bblacey/MySensorIRBlaster/Schematic.pdf

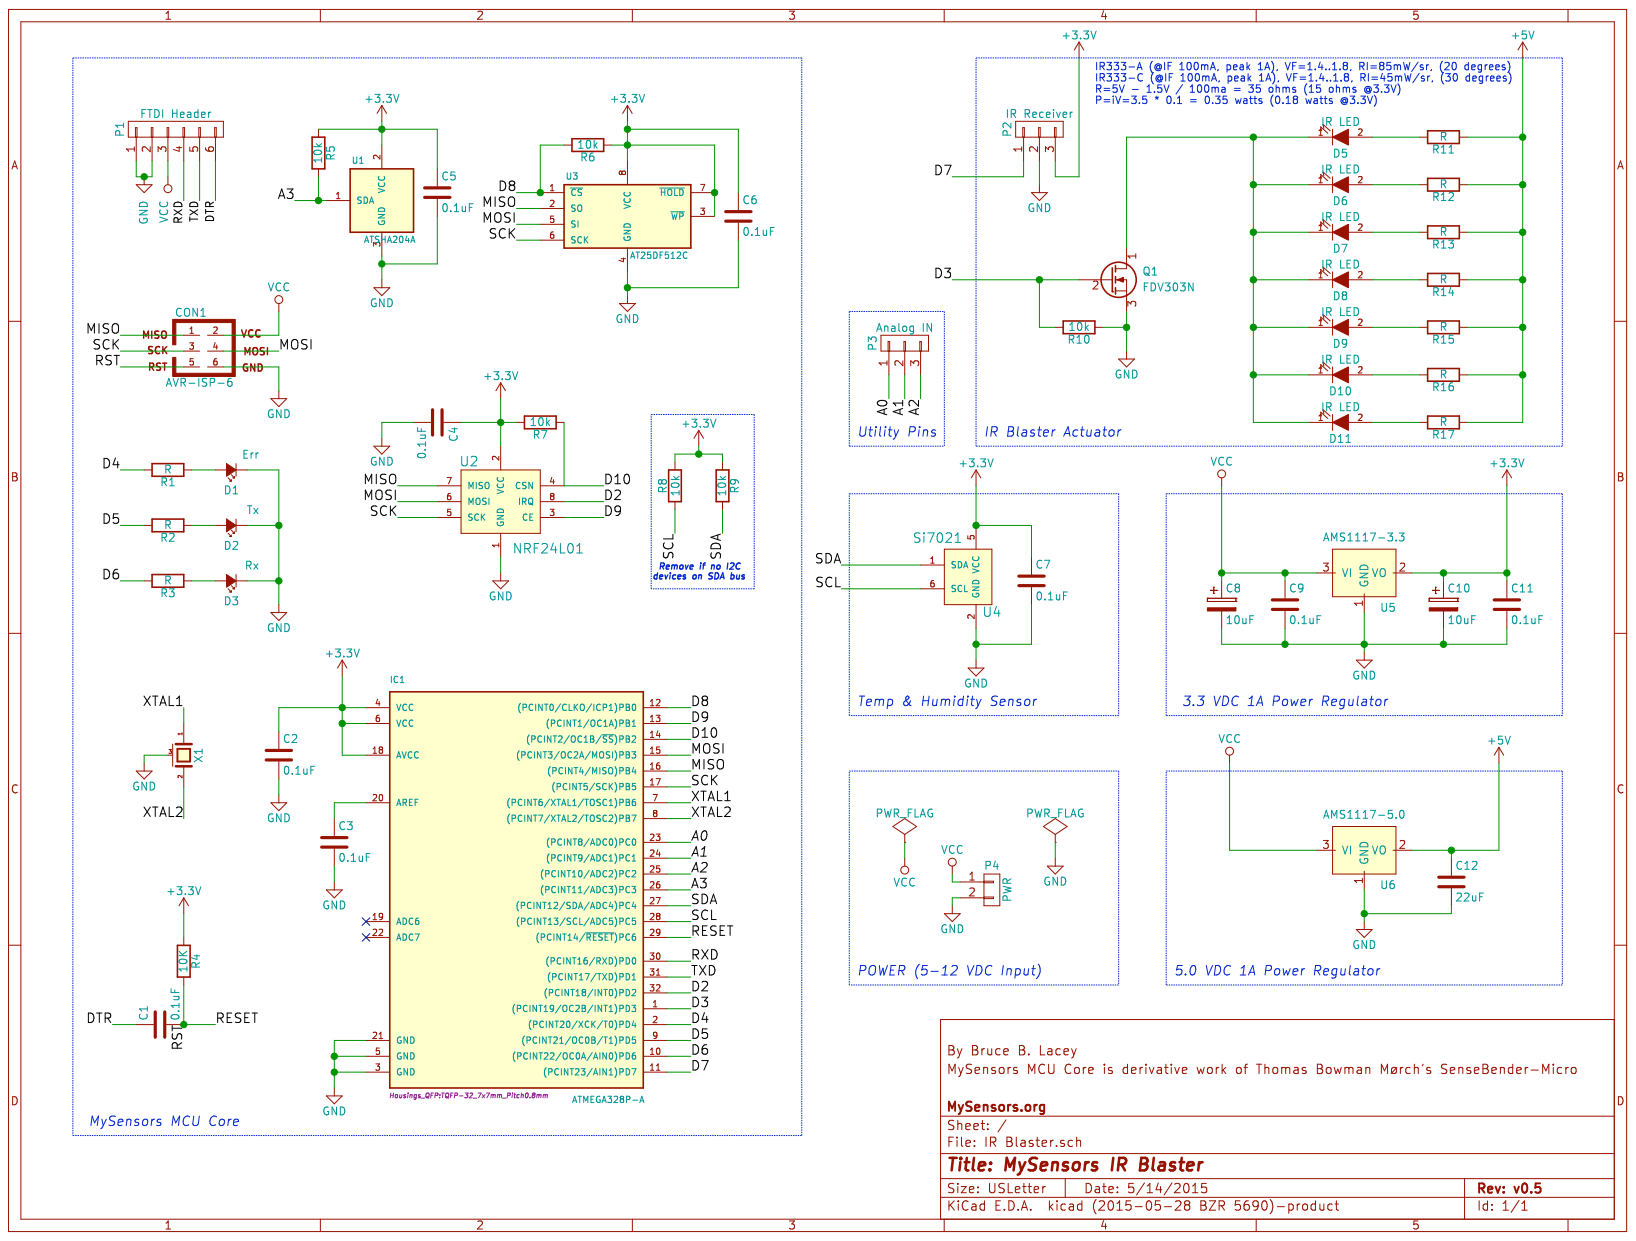
[picture p1: page 1]
