bblacey/MySensorIRBlaster/IR Blaster.kicad_pcb

## KiCad design IR Blaster.kicad_pcb (2015-06-25)

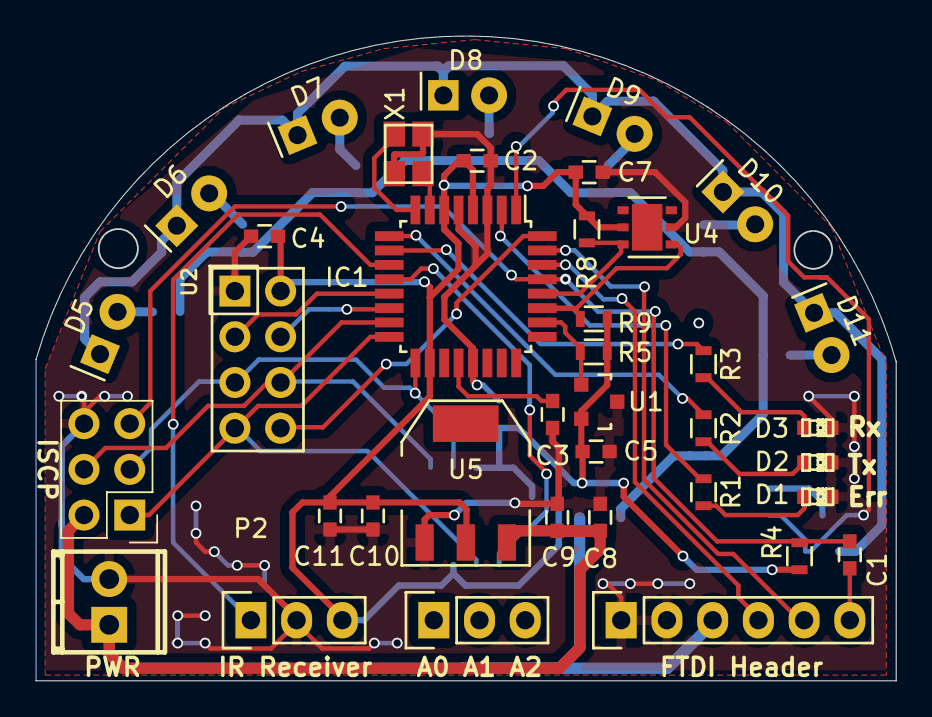
[picture p2: board IR Blaster.kicad_pcb from above]

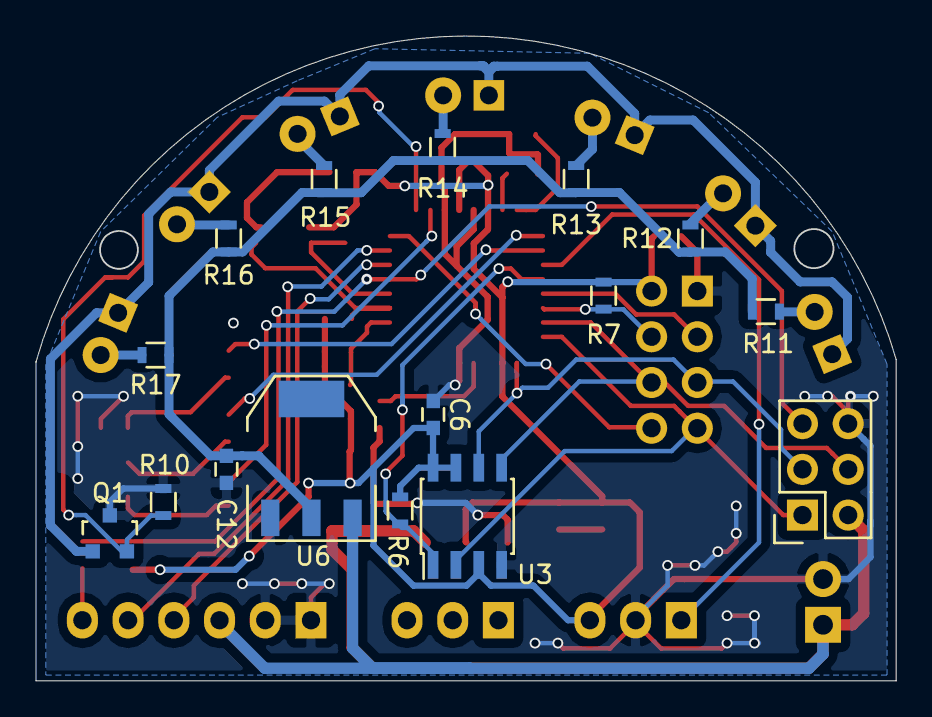
[picture p3: board IR Blaster.kicad_pcb from below]

Board: 2 copper layers, 47.8 x 35.8 mm, 53 parts (16 on the bottom side), 40 nets.

Parts:
C1, C2, C3, C4, C5, C6, C7, C9, C11: 0.1uF; C_0603
C8, C10: 10uF; C_0603
C12: 22uF; C_0603
CON1: AVR-ISP-6; Socket_Strip_Straight_2x03
D1: Err; LED-0603
D2: Tx; LED-0603
D3: Rx; LED-0603
D5, D6, D7, D8, D9, D10, D11: IR LED; LED-5MM-Horizontal
IC1: ATMEGA328P-A; TQFP-32_7x7mm_Pitch0.8mm
P1: FTDI Header; Pin_Header_Straight_1x06
P2: IR Receiver; Socket_Strip_Straight_1x03
P3: Analog IN; Pin_Header_Straight_1x03
P4: PWR; TerminalBlock2.54mmx2-kcswalter
Q1: FDV303N; SOT-23
R1, R2, R3, R11, R12, R13, R14, R15, R16, R17: R; R_0603
R4: 10K; R_0603
R5, R6, R7, R8, R9, R10: 10k; R_0603
U1: ATSHA204A; SOT-23
U2: NRF24L01
U3: AT25DF512C; SOIC-8_3.9x4.9mm_Pitch1.27mm
U4: Si7021; DFN-6-1EP_3x3mm_Pitch0.95mm
U5: AMS1117-3.3; SOT-223
U6: AMS1117-5.0; SOT-223
X1: CRYSTAL; crystal_FA238-TSX3225

Connections:
+3V3: C2.1, C4.1, C5.1, C6.1, C7.1, C10.1, C11.1, IC1.4, IC1.6, IC1.18, P2.3, R4.1, R5.1, R6.1, R7.2, R8.2, R9.1, U1.2, U2.2, U3.3, U3.7, U3.8, U4.5, U5.2
+5V: C12.1, R11.1, R12.1, R13.1, R14.1, R15.1, R16.1, R17.1, U6.2
/A0: IC1.23, P3.1
/A1: IC1.24, P3.2
/A2: IC1.25, P3.3
/A3: IC1.26, R5.2, U1.1
/D2: IC1.32, U2.8
/D3: IC1.1, Q1.2, R10.2
/D4: IC1.2, R1.2
/D5: IC1.9, R2.2
/D6: IC1.10, R3.2
/D7: IC1.11, P2.1
/D8: IC1.12, R6.2, U3.1
/D9: IC1.13, U2.3
/D10: IC1.14, R7.1, U2.4
/DTR: C1.1, P1.6
/MISO: CON1.1, IC1.16, U2.7, U3.2
/MOSI: CON1.4, IC1.15, U2.6, U3.5
/RESET: C1.2, CON1.5, IC1.29, R4.2
/RXD: IC1.30, P1.4
/SCK: CON1.3, IC1.17, U2.5, U3.6
/SCL: IC1.28, R8.1, U4.6
/SDA: IC1.27, R9.2, U4.1
/TXD: IC1.31, P1.5
/XTAL1: IC1.7, X1.1
/XTAL2: IC1.8, X1.2
GND: C2.2, C3.2, C4.2, C5.2, C6.2, C7.2, C8.2, C9.2, C10.2, C11.2, C12.2, CON1.6, D1.1, D2.1, D3.1, IC1.3, IC1.5, IC1.21, P1.1, P1.2, P2.2, P4.2, Q1.3, R10.1, U1.3, U2.1, U3.4, U4.2, U5.1, U6.1, X1.3
unnamed: C3.1, IC1.20
unnamed: D1.2, R1.1
unnamed: D2.2, R2.1
unnamed: D3.2, R3.1
unnamed: D5.2, R11.2
unnamed: D6.2, R12.2
unnamed: D7.2, R13.2
unnamed: D8.2, R14.2
unnamed: D9.2, R15.2
unnamed: D5.1, D6.1, D7.1, D8.1, D9.1, D10.1, D11.1, Q1.1
unnamed: D10.2, R16.2
unnamed: D11.2, R17.2
VCC: C8.1, C9.1, CON1.2, P1.3, P4.1, U5.3, U6.3
