bblacey/MySensorIRBlaster/(threads)

Thread 1 (2015-07-04):

Change MOSFET footprint to GSD and re-route

bblacey, 2015-07-04:
The current MOSFET DGS footprint is less common for enhanced MOSFETs eliminating a large number of good candidates.  Need to rev the PCB to use a GSD footprint

Thread 3 (2015-07-04):

Learn mode activation

bblacey, 2015-07-04:
Currently there is not a convenient way to place the IR Blaster into learn mode.  One option is to detect the presence of an IR Receiver in the socket during firmware boot, another would be to send a message from the HA Controller or a third is to consider adding a small physical button to the PCB (cost?).

Thread 4 (2015-07-04):

Re-route MOSFET gate trace around hold-down screw to reduce probability of fastener damage

bblacey, 2015-07-04:
Currently the MOSFET gate line is routed around the outside of the LED array and past the interior side of the hold-down screw hole.  It is close enough that if users tighten the hold-drown screw, it could damage the trace.

Thread 5 (2015-07-04):

Increase clearance between D5 trace and AMS1117 LDO regulator on bottom-side

bblacey, 2015-07-04:
While it is within the design specs, the trace appears to be physically closer to the AMS1117 large pin than desired.

Thread 6 (2015-07-07):

Finalize 3.3v MCU power regulator coupling capacitors

bblacey, 2015-07-07:
Ensure 3.3v coupling capacitor capacity is sufficient to handle MCU, flash, ASTHA crypto chip and radio power surge demands.

bblacey, 2015-07-09:
LDO will oscillate and won't settle unless capacitors are of sufficient capacitance.  Ceramic and Tantalum capacitance differ in an important manner for the input side (RMS or EMF which is a secondary value but also important).  Arduino tends to use 47uf on the input side.

Thread 7 (2015-07-07):

Correct crystal footprint for 8-12MHz SMD crystals

bblacey, 2015-07-07:
The current footprint accommodates a 32MHz crystal but needs to accommodate an 8-12MHz SMD crystal @3.3VDC.  The common footprint size seems to be 5mm x 3.2mm dual pad.  Representative crystals can be found here http://www.mouser.com/Passive-Components/Frequency-Control-Timing-Devices/Crystals/_/N-6zu9f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

bblacey, 2015-07-12:
Crystals - http://www.tme.eu/en/pages/New_Product:smd-quartz-crystals-from-yic.html

Thread 8 (2015-07-07):

Formally include BOM parts in KiCad

bblacey, 2015-07-07:
1.  Define BOM parts in schematic symbol labels
2.  Create BOM extraction using Python scripts that Patrick provided

Thread 9 (2015-07-07):

5VDC vs. 3.3VDC for IR LED circuit

bblacey, 2015-07-07:
The v0.5 version of the IR LED circuit was 5V requiring 35 ohm 0.35watt current limiting resistors and was laid out using 0603 resistor footprints.  During part selection, I found that it was nearly impossible to find a resistor that could meet the power requirements so for the dev board, I reverted to driving the IR LEDs with 3.3v allowing the use of a 15 ohm 0.18 watt resistor in the 0603 package.

The open issue is which voltage should be used for the final board.  If 5VDC, then at a minimum, we need to change the resistor footprint to 0805.

tbowmo, 2015-07-08:
If you could put in an extra led,  so you have 8 in total,  then put  2 in series with a resistor,  multiply with 4. Will also lower the current through the FET.

bblacey, 2015-07-08:
Good idea Thomas.  What if I used 3-pair plus one single?  I would still have 4x100mA current draw through the FET and I think I would only need to use slightly different current limiting resistors for the 1 vs. pairs to do it.  In fact, the IR LED FV is 1.4-1.8 at 100mA so I would only need to offset from 3.3 down to 2.8-3.6 so maybe I wouldn't even need a current limiting resistor for the pairs. Do you see any significant issues with that approach?  The IR design uses an odd number of LEDs so that one of them is completely forward-facing at a 0-degree angle for maximum range.

Another advantage for using 3.3VDC for the IR LED circuit is that if there are two LDOs, one won't need to dissipate a larger voltage differential between the power supply and the 3.3VDC LDO and users would be able to use a more common 5VDC power supply.  Taking it a step further would be to consolidate to a single LDO (the AMS1117 can push 1A) with additional capacitance to compensate and push all components to the top-side while still keeping the board under 5x5cm...  Good idea/bad idea?

tbowmo, 2015-07-08:
Hmm of course you could just have 7 leds, with a larger resistor for the
lonely led.

Could probably also go with a single ldo. But definitely need  good
decoupling so the 38khz carrier frequency doesn't mess up the nrf24 module,
or other things on board. I think you should make some prototype to
evaluate the led circuitry. And check if resistors can be left out.

Good idea Thomas. What if I used 3-pair plus one single? I would still have
4x100mA current draw through the FET and I think I would only need to use
slightly different current limiting resistors for the 1 vs. pairs to do it.
In fact, the IR LED FV is 1.4-1.8 at 100mA so I would only need to offset
from 3.3 down to 2.8-3.6 so maybe I wouldn't even need a current limiting
resistor for the pairs. Do you see any significant issues with that
approach? The IR design uses an odd number of LEDs so that one of them is
completely forward-facing at a 0-degree angle for maximum range.

Another advantage for using 3.3VDC for the IR LED circuit is that if there
are two LDOs, one won't need to dissipate a larger voltage differential
between the power supply and the 3.3VDC LDO and users would be able to use
a more common 5VDC power supply. Taking it a step further would be to
consolidate to a single LDO (the AMS1117 can push 1A) with additional
capacitance to compensate and push all components to the top-side while
still keeping the board under 5x5cm... Good idea/bad idea?

—
Reply to this email directly or view it on GitHub
<https://github.com/bblacey/MySensorIRBlaster/issues/9#issuecomment-119444776>
.

bblacey, 2015-07-09:
Interesting test of the IR LEDs.
The datasheet states typical VF is 1.2 for IF 20mA.
And 1.4 for 100mA.
I have one connected to a bench supply.

* At 1.0 VDC, it is drawing 26mA
* 1.1 = 50mA
* 1.2 = 82mA
* 1.3 = 155mA
* 1.4 = whopping 260mA!

Far cry from the data sheet. So pairing is a good idea unless we use a heavy duty FET 😉I should try a few to see the variance between individual LEDs.
And my bench supply isn't the most accurate.  I should actually use a couple of meters to measure voltage and current separately from the bench supply.

Thread 10 (2015-07-09):

Gerber top copper pour shorts trace D10

bblacey, 2015-07-09:
For some reason, the v0.5 Gerbers short trace D10 to the top-side copper pour.  This needs to be investigated and fixed.

Thread 11 (2015-07-09):

Evaluate using the SAM D2x series MCU in lieu of the 328p & companion 512Kb flash for MySensors Core

bblacey, 2015-07-09:
The ATMEL D2x series MCU seems like a good candidate for the MySensors MCU core because it is equipped with up to 256KB of on-board flash for program memory and 32KB RAM for data - the increased flash might be sufficient for OTA allowing us to reduce the total part count.  The SAM D2x series uses a 32-bit ARM Cortex M0 CPU that can be clocked to 48MHz.

* D20G18A-AU is a good Sensor/Actuator candidate and can be purchased for as low as $2.44/ea - http://www.newark.com/atmel/atsamd20g18a-au/microcontroller-mcu-32-bit-cortex/dp/19X7616
* Comes in a TQFP-48 package that is physically the same dimensions as the 328p but packs 16 more pins in by adding 4 pins/side at a 0.05mm pitch (versus 328p 0.08mm pitch)
* Operating voltage 1.62V - 3.63V
* Power consumption: 8uA - 70uA/MHz (idle and standby sleep modes, sleepWalk peripherals)
* 256KB flash, 32KB RAM
* 38 GPIO pins
* 6 Timer Counters that can be used for PWM
* Two-pin SWD programming, test and debug :+1:
* Brown out detection and Watchdog

The Arduino Zero uses the D21E that adds USB.

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

@tbowmo and @fallberg, it would be great if you guys would weigh in on this...  Seems like an interesting option but what do you guys think?

tbowmo, 2015-07-09:
Hmm sounds interesting. But is all software directly compatible with it? (of course with appropriate  compiler)

Next question. What programmer is needed to do initial programming? Can it be reprogrammed via USB? Thinking about end users here, do they need to buy new hardware to use it with their own sketch?
Can we do Ota updates easily?

tbowmo, 2015-07-09:
Been looking at the schematic of arduino zero, it's a two processor design, implementing an atmega32u4 as a programming device for the SAM. an jtagice3 could also be used to programming the SAM.

At a first glance, this means that the end user is not able to program this device easily with arduino, unless we also implement the atmega32u4 on board to handle things. Or the end user needs to purchase a new programming device.

I haven't looked deeply into the datasheets yet, so this is just from an initial browsing on documents, both on arduino zero, and on atmel SAM D20 feature leaflets. So I might be wrong in my assumptions

bblacey, 2015-07-09:
Peter Easton, the author of ControLeo pointed me to the [Neutrino - an Arduino Zero compatible kickstarter project](https://www.kickstarter.com/projects/rabidprototypes/neutrino-the-tiny-32-bit-arduino-zero-compatible/description) (He is planning to use the Atmel SAM for his next project).  The schematic is below and seems pretty straight-forward.

[Schematic page 1](http://rabidprototypes.com/Neutrino/Neutrino-150-Schematic-1.png)
[Schematic page 2](http://rabidprototypes.com/Neutrino/Neutrino-150-Schematic-2.png)

Also, if we went this way, we would probably want to go with the D21G18A-AU for maximum Arduino IDE and library compatibility.  Mouser has D21G18A-AU for $4.56 in quantities of 10.

I used the Arduino Board Manager to add support for the SAMD Arduino and then looked at the boards.txt section - looks pretty straight-forward:

```
arduino_zero_edbg.name=Arduino Zero (Programming Port)
arduino_zero_edbg.vid.0=0x03eb
arduino_zero_edbg.pid.0=0x2157
arduino_zero_edbg.upload.tool=openocd
arduino_zero_edbg.upload.protocol=sam-ba
arduino_zero_edbg.upload.maximum_size=262144
arduino_zero_edbg.upload.use_1200bps_touch=false
arduino_zero_edbg.upload.wait_for_upload_port=false
arduino_zero_edbg.upload.native_usb=false
arduino_zero_edbg.build.mcu=cortex-m0plus
arduino_zero_edbg.build.f_cpu=48000000L
arduino_zero_edbg.build.usb_product="Arduino Zero"
arduino_zero_edbg.build.usb_manufacturer="Arduino LLC"
arduino_zero_edbg.build.board=SAMD_ZERO
arduino_zero_edbg.build.core=arduino
arduino_zero_edbg.build.extra_flags=-D__SAMD21G18A__ {build.usb_flags}
arduino_zero_edbg.build.ldscript=linker_scripts/gcc/flash_with_bootloader.ld
arduino_zero_edbg.build.openocdscript=openocd_scripts/arduino_zero.cfg
arduino_zero_edbg.build.variant=arduino_zero
arduino_zero_edbg.build.variant_system_lib=
arduino_zero_edbg.build.vid=0x2341
arduino_zero_edbg.build.pid=0x804d
arduino_zero_edbg.bootloader.tool=openocd
arduino_zero_edbg.bootloader.file=zero/samd21_sam_ba.bin
```

Should use the same programmers, etc. but need to verify.  Intriguing to say the least...  I would like to hear from @henrikekblad if 64K words (32-bit word size) is sufficient for a sketch and an OTA update.  The current 328p design has 32K words (8-bit word size) on board plus the 512 Kb (64K words) off-board  so how much do we need for OTA updates and will it work?  Sketches would need to stay below 32K words I suspect.

tbowmo, 2015-07-09:
One thought, is the libraries that we need ported? Can we use the arduino DUE (It's using an cortex m3) as a mysensors gateway?

I think we need to have a POC running with the processor, a radio module (ideally both nrf24 and rfm69) and check that we can communicate with the sensor network successfully.. Also check that we can use w5100 / esp8266 for wired / wireless "internet" access

One part I really like about it, is that it's running on 3v3.. So I can skip all level converters, and run everything on a single vcc rail in the GW.

bblacey, 2015-07-09:
I have ordered two [Neutrinos](http://rabidprototypes.com/product/neutrino/) for $20/each and also saw that you can buy an a [SAM D21 Xplained Pro Evaluation Kit](http://www.atmel.com/tools/ATSAMD21-XPRO.aspx) for $42.65 from ATMEL - of course, there is always the [Arduino Zero](http://store-usa.arduino.cc/products/abx00003) for $50 but it probably contains more "parts" than what we want to use as a reference.  Both boards come with 256KB flash so they each would be good platforms for experimentation.

Emmanul123456, 2017-01-06:
@bblacey
hello friend ,I am a beginner in programming, and I am using SparkFun SAMD21 Dev Breakout, I am enthusiastic since you mention uploading sketch through OTA, I would like to know if you accomplished your task, I have a school project and I would like to implement it through GPRS, you could mention me as I can get to this, thank you.

bblacey, 2017-01-07:
@Emmanul123456, the new MySensors gateway uses the SAMD21 processor but does not require OTA.  @tbowmo designed and implemented the MySensors gateway and is also working on a [major revision to his original sensebender micro sensor](https://forum.mysensors.org/topic/5329/sensebender-micro-mk2/12) that will also use a SAMD processor.  OTA is performed by the bootloader and currently the [MYSBootloader](https://forum.mysensors.org/topic/5665/mysbootloader-1-3-0-beta-3/4) that currently runs on the ATMEL, ATMEGA AVR MCUs. @tekka, is the core member for the MYSBOOTLOADER and has  not yet had time to port develop OTA support for the SAMD line of MCUs.  I suggest that you post these questions to the [MySensors forums](https://forum.mysensors.org/category/13/development) in order to get better support because all the MySensors core members and the vibrant community members are active on the forums and can advise and help you with your project.  Good luck with your project and welcome to MySensors!

Thread 12 (2015-07-09):

Simplification & Cost Reduction - move all components to top side

bblacey, 2015-07-09:
Consider moving all components to the top-side of the board, without exceeding the lowest fab-cost 5x5cm standard, to simplify assembly and reduce board cost - @fallberg mentioned this earlier on a Hangouts thread.

Considerations:

* Part reduction (e.g. move from dual to single LDO in #9, MCU/Flash consolidation #11, non-essential pads/sockets, etc.)
* Increase the board height slightly - currently 3.59cm high so we have almost 1.5cm of additional vertical board space we can add
* Opportunity to re-orient radio to provide ample antenna clearance?

/cc @tbowmo @fallberg

Thread 13 (2015-07-09):

Review PCB layout for adherence to design best practices

bblacey, 2015-07-09:
[How to Design the Perfect PCB – Part 1](http://michaelhleonard.com/how-to-design-the-perfect-pcb-part1/)
[How to Design the Perfect PCB – Part 2](http://michaelhleonard.com/how-to-design-the-perfect-pcb-part2/)

Thread 14 (2015-07-10):

Add FTDI pin labels

bblacey, 2015-07-10:
Currently the FTDI pins are not labeled - this needs to be corrected.

Thread 15 (2015-07-13):

Constant-Current IR LED circuit for maximum IR luminance?

bblacey, 2015-07-13:
Compare with v0.5 parallel IR LEDs driven by a high-current FET.  At 3.3VDC, will need to drive 3 pair with 1 single.  5 VDC?

[Sharp IR LED Circuits](http://www.analysir.com/blog/wp-content/uploads/2013/11/Sharp-IR-LED-Circuits.pdf?5b4871_
[Constant current infrared LED emitter circuit](http://www.analysir.com/blog/2013/11/22/constant-current-infrared-led-circuit/)

/cc @fallberg

bblacey, 2015-07-13:
[FET/NPN constant current](http://www.instructables.com/id/Power-LED-s---simplest-light-with-constant-current/)
[TI constant current LED driver](http://www.ti.com/product/tlc59108/description)
[ST constant current LED driver](http://www.st.com/web/en/resource/technical/document/datasheet/CD00156241.pdf)

bblacey, 2015-07-13:
@fallberg, the more I read about this, the more I am convinced that putting the IR LEDs on a constant current circuit is the way to go.  I haven't done all the math but we can completely separate the MCU IC core on 3.3VDC from the IR LEDs and use the sense resister to compensate for varying input voltages.  So, we can drive the board with up to 12V (AMS1117 max VDC), and use an non-voltage regulated constant-current circuit to drive the LEDs.  I have included some short reads on the subject - including cheap DIY circuits that use a FET for switching and a sense resistor and NPN transistor for the current regulation...  Check them out and let me know your thoughts.

tbowmo, 2015-07-13:
Hmm have actually been thinking about the constant current, but am a bit uncertain about the switching circuit.

You can probably use an 1117 as CC source,  (you can with an lm317)

bblacey, 2015-07-13:
@tbowmo thanks for the insight on the lm317 as a CC source - we should be able to switch with a FET after the CC regulator, right?  Is your uncertainty about circuit integrity?

That said, it is clear that we have a number of options (VR as CC, NPN pair w/resistor, FET/NPN pair w/resistor, or some CC LED driver).  I guess in the end we will need to consider part count and cost - the odd number of LEDs may sway me towards a driver such as the [CAT 4101 LED Driver with PWM control](http://www.onsemi.com/pub_link/Collateral/CAT4101-D.PDF) that can take 3-6VDC and drive in-series LEDs up to 1A (we need 700mA)...  This particular part is a bit bigger and more expensive than what we may want but a single package for an array of in-series LEDs with constant current is and built-in switching is very attractive...  With a bit of searching, we might be able to find a similar part that is smaller and less expensive.

bblacey, 2015-07-13:
Another TI argument against parallel LEDs...

>Pitfalls of Parallel LED Arrays
Whenever LEDs are placed in parallel, the potential exists for a mismatch in the current that flows through the different branches. The forward voltage, VF, of each LED varies with process, so unless each LED is binned or selected to match VF, the LED or LED string with the lowest total forward voltage will draw the most current (Figure 4). This problem is compounded by the negative temperature coefficient of LEDs (and all PN junction diodes). The LEDs that draw the most current suffer the greatest increase in die temperature. As their die temperature increases, their VF decreases, creating a positive feedback loop. Elevated die temperature both reduces the light output and decreases the lifetime of the LEDs.

Reference: http://www.ti.com/lit/an/snva253a/snva253a.pdf

fallberg, 2015-07-13:
A cheap LED driver circuit would probably be the best option since it reduces both the number of necessary components, provides a tested environment (within specifications) and (I suppose) cost less PCB area to implement.

Thread 17 (2015-09-07):

Learning circuit should use both TSOP and TSMP receiver for increased accuracy

bblacey, 2015-09-07:
Extend IR Receiver circuit to allow dual use of a TSOP and a TSMP device connected to 2 different pins in order to simultaneously measure frequency to increase decode accuracy.

Single TSOP should be supported as well.

http://tech.cyborg5.com/irlib/docs/1-irlib-reference/1-1-receiver-classes/1-1-7-irfrequency-class/

fallberg, 2015-09-07:
Jenkins did not trigger because I currently tear up stuff. I will schedule a build once I am done...

fallberg, 2015-09-07:
ops, wrong repo. Of course jenkins did not do anytning. This is your repo and I happend to get a notification :D
