bblacey/MySensorIRBlaster/(commit log)

2015-06-02 Importing version 0.3 of the IR Blaster KiCad project into git for version management. Currently a 5 LED design dual voltage design.
    [IR Blaster.kicad_pcb, IR Blaster.sch]
2015-06-18 Modified design to increase LEDs from 5 @30 degrees to 7 @22.5 degrees to cover 180 degrees with greater distance using narrower angluar displacement IR LEDs. Completed electrical traces except for o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
    [IR Blaster.kicad_pcb, IR Blaster.sch]
2015-06-20 General PCB tidying. Added board identifier and OSHW logo, tweaked LED orientation, corrected paths for 3d model view, added top-side silk screen identifiers for connectors, re-oriented ISCP connecto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
    [IR Blaster.kicad_pcb]
2015-06-20 Cleaned up 3D parts (power terminal block and 0603 LEDs) in preparation for v0.4 post and review.
    [IR Blaster.kicad_pcb, IR Blaster.sch]
2015-06-24 Project should now be location independent users who have established mysensors part management prequisites as defined on https://github.com/mysensors-kicad/part_management. Implemented MySensors pat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
    [IR Blaster.kicad_pcb, IR Blaster.sch]
2015-06-24 Project now uses project-local and writable cow directory and updated to the latest NRF24L01+ footprint and 3d shape.
    [IR Blaster.kicad_pcb]
2015-06-25 Increased higher-current trace widths to ensure ample current to higher-drain parts such as the LEDs.
    [IR Blaster.kicad_pcb]
2015-06-25 Added some modest via stitching to the ground planes.
    [IR Blaster.kicad_pcb]
2015-06-25 Changed references for Walter Lain 3dshapes from personal library to mysensors.3dshapes repo.
    [IR Blaster.kicad_pcb]
2015-06-25 Updated revision from v0.4 to v0.5 for first board run.
    [IR Blaster.kicad_pcb, IR Blaster.sch]
2015-06-25 Resolved fab house design requirement violations. "Stitched" vias exceeded minimum drill size for fab house and wider pwr traces were closer to the edge than the minimum allow.
    [IR Blaster.kicad_pcb]
2015-06-25 Added Manufacturing directory following Patrick's convention. This ensures consistent Gerber archive generation for specific fab houses, in this case Smart Prototypes.com
    [IR Blaster-B_Cu.gbl, IR Blaster-B_Mask.gbs, IR Blaster-B_Paste.gbp, IR Blaster-B_SilkS.gbo, IR Blaster-Edge_Cuts.gbr, IR Blaster-F_Cu.gtl, IR Blaster-F_Mask.gts, IR Blaster-F_Paste.gtp]
2015-06-25 Added a create_OSHPark.sh Gerber generation script to Manufacturing directory for quick verification of Gerbers and for those users who might prefer to use OSHPark for fabbing.
    [MySensorsIRBlaster-BTM_MASK.GBS]
